MartinNohr/FilamentScale/README.md

# FilamentScale
This is the code for the 3d filament printer weight scale as found in thingiverse and cults3d.
