MartinNohr/FilamentScale/Filament Scale Notes.docx

# Features to Add or Change

# Main Screen

Show spool #

Show remaining weight and length

Show spool weight?

Show rate of consumption?

# Menu Items

## Select Spool

## Change Spool

## Set Weight of full spool

## Calibrate Scale

## Manually set remaining weight
