MartinNohr/FilamentScale/3D/rotator.3mf

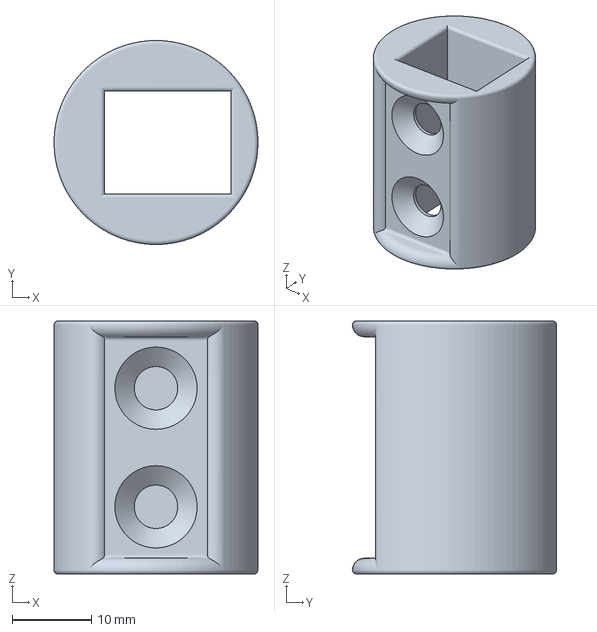
[picture p2: CAD file, 2023-07-01]
3D/rotator.3mf
25.8 x 25.8 x 32.0 mm
