MartinNohr/FilamentScale/3D/mount block.3mf

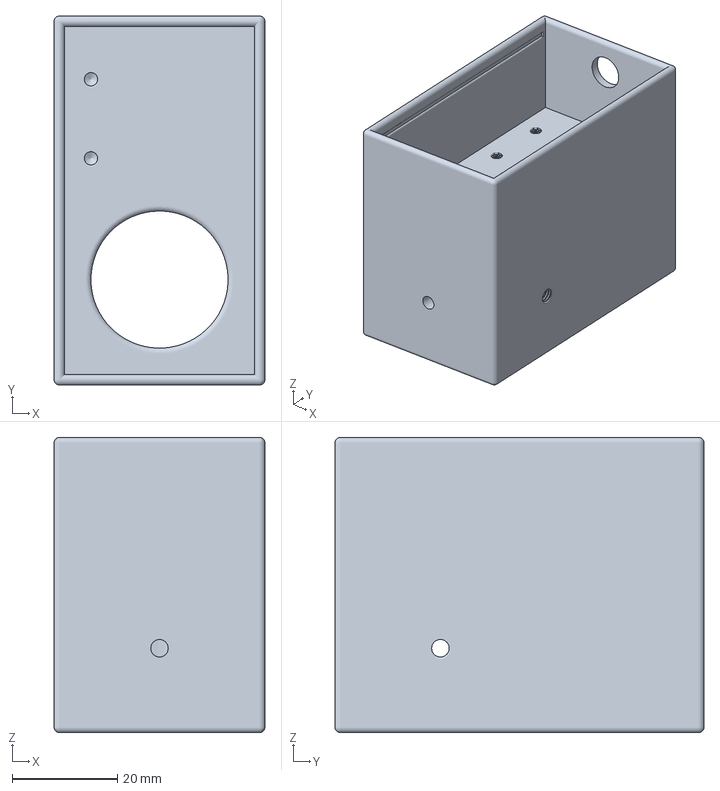
[picture p3: CAD file, 2023-07-01]
3D/mount block.3mf
40.0 x 70.0 x 56.0 mm
