MartinNohr/FilamentScale/3D/inner shaft.3mf

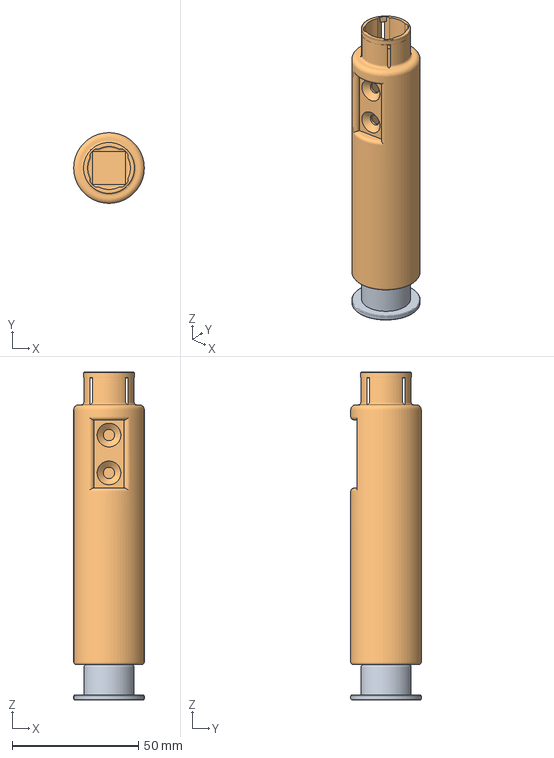
[picture p4: CAD file, 2023-07-01]
3D/inner shaft.3mf
28.0 x 28.0 x 130.0 mm
bearing holder
main shaft
