MartinNohr/FilamentScale/3D/Circuit Cover.3mf

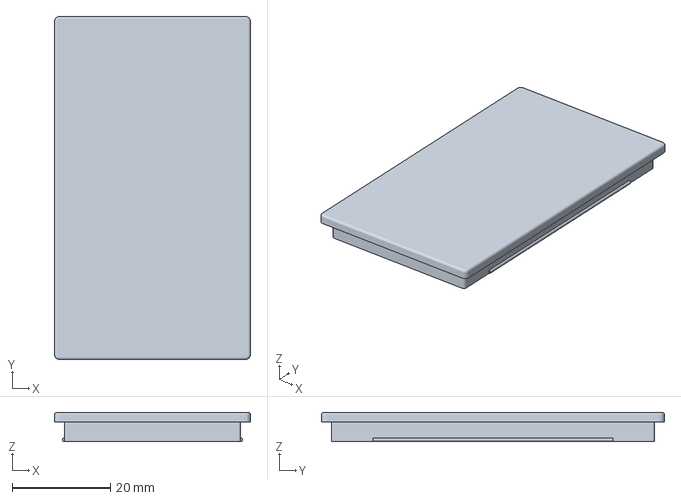
[picture p5: CAD file, 2023-07-01]
3D/Circuit Cover.3mf
40.0 x 70.0 x 6.00 mm
