MartinNohr/FilamentScale/3D/spool shaft.3mf

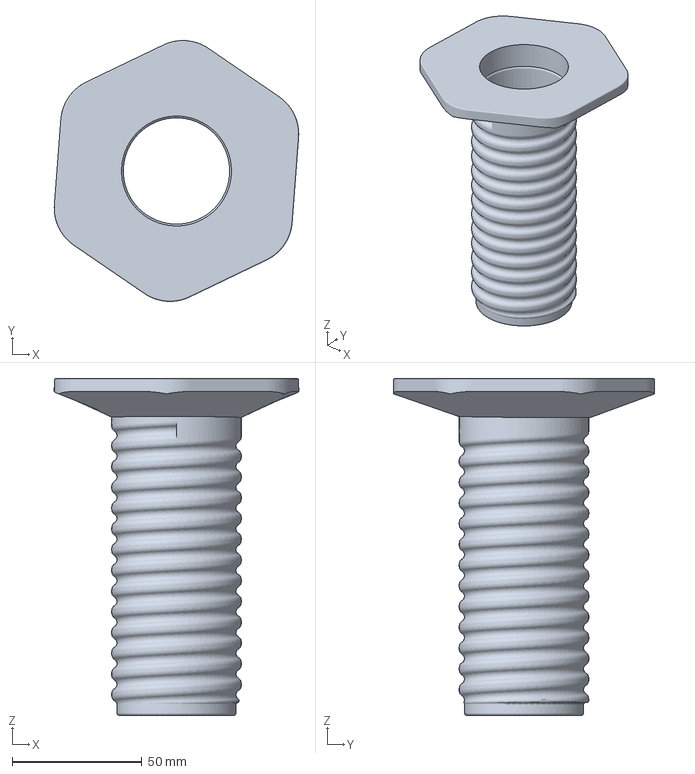
[picture p6: CAD file, 2023-07-01]
3D/spool shaft.3mf
94.3 x 100.6 x 130.0 mm
