MartinNohr/FilamentScale/3D/nut.3mf

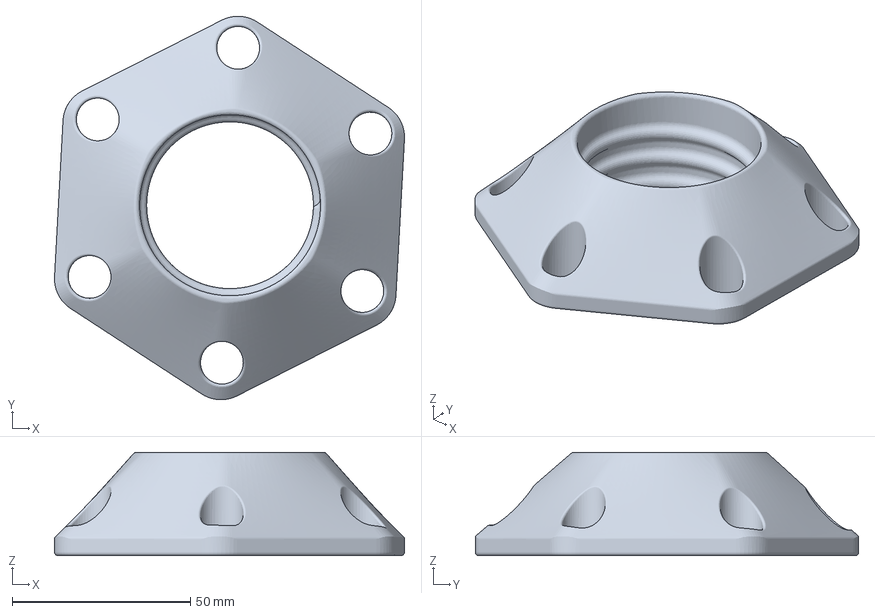
[picture p7: CAD file, 2023-07-01]
3D/nut.3mf
98.2 x 107.6 x 29.0 mm
