MartinNohr/FilamentScale/(list of files, cad)

Other CAD files:
3D/Spool Scale Bracket Rotatable v26.f3d
