MartinNohr/FilamentScale/(threads)

Thread 1 (2021-02-04):

Ground wire needed on loadcell

MartinNohr, 2021-02-04:
I've noticed that the load cell is very sensitive to electrical noise or even being touched with static electricity. It might be helpful to add a ground wire connected to the loadcell.
