MartinNohr/FilamentScale/Schematic_Filament Weigh Scale_2023-06-30.pdf

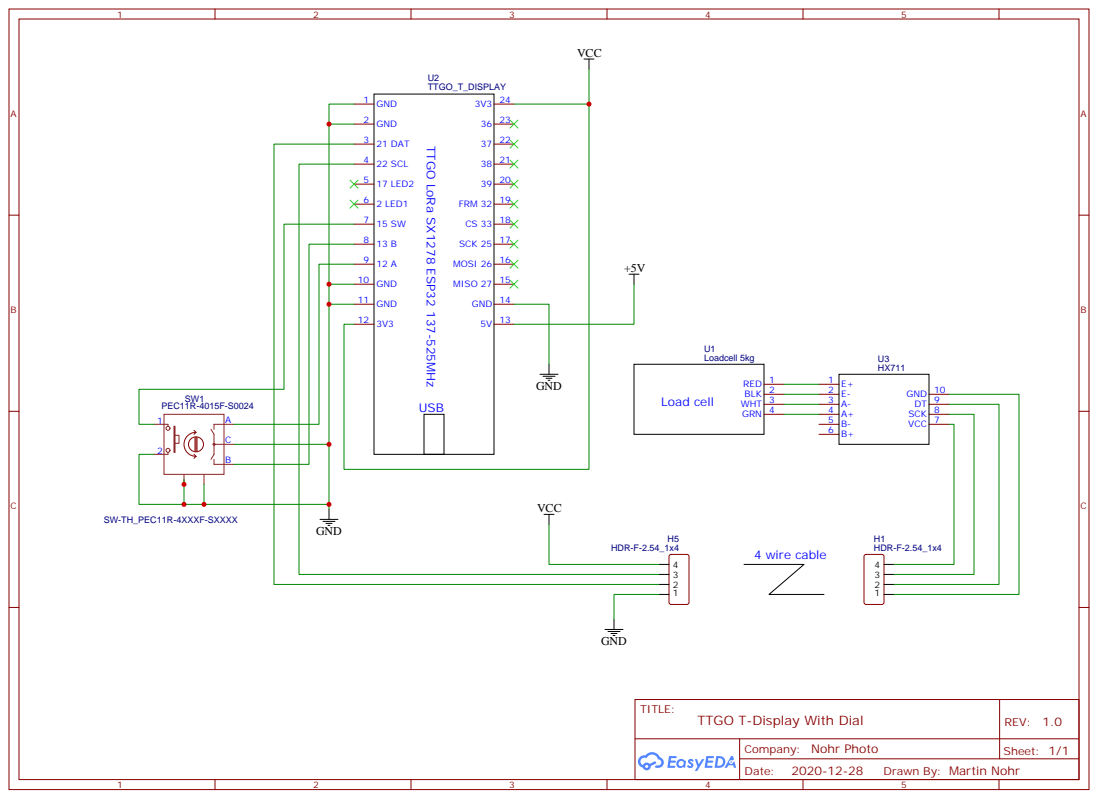
[picture p8: page 1]

Drawn By: Martin Nohr
