MartinNohr/FilamentScale/(commit log)

2021-01-09 Create README.md
    Weighs the amount of filament left on the spool.
    It keeps a list of spools by number so when a spool is switched it can be changed to that spool number to keep track of how much filament is left.
2021-01-22 Improvements to measuring calibration.
2021-01-24 Many fixes, many more to come.
    [FilamentScale.ino]
2021-01-24 Added calibration code.
2021-01-25 Working on calibrate.
2021-01-28 Work on calibration to use dial.
2021-01-28 Calibration almost working.
2021-01-28 Calibration changes.
2021-01-29 Improved calibration code.
2021-01-30 Fixed nActiveSpool to be 1-based.
    [FilamentScale.h, FilamentScale.ino]
2021-01-30 Some menu fixes, long press for access to menu.
    [FilamentScale.h, FilamentScale.ino]
2021-01-30 Fixed spool weight setting.
    [FilamentScale.h, FilamentScale.ino]
2021-01-30 Added tare command and save tare offset. This should allow us to remember settings between power.
2021-01-31 Calibration working again, it was broken.
    [FilamentScale.h, FilamentScale.ino]
2021-01-31 Added spool chooser to spool settings menu. Removed some redundant printlines.
2021-02-01 Some tare and cal save issues fixed.
    [FilamentScale.ino]
2021-02-02 Removed old Serial.println calls and unused eCurrentFile menu code.
2021-02-02 Fixed decimal display while entering integers.
    [FilamentScale.h, FilamentScale.ino]
2021-02-02 Fixed min/max display for decimals in getinteger code.
    [FilamentScale.h, FilamentScale.ino]
2021-02-03 Fixed using filament full length for % full conversion.
    [FilamentScale.ino]
2021-02-03 Added filament usage rate.
2021-02-04 Added schematic to doc.
2021-02-08 Changed calibration text.
2021-02-10 Adjustments for the dial on the PCB.
2021-02-16 Fixed a hang situation if no loadcell. This resulted in killing the bootloader.
    [FilamentScale.ino]
2021-02-24 Fixed calval warning range.
    [FilamentScale.ino]
2021-02-24 Calibration values can be <0! Allow them.
2021-03-09 Change full spool menu to full filament to better reflect what it means.
2021-03-17 Added system menu with brightness, reboot, etc. Put in startup changes for 0 calval so the calibrate code still works.
    [FilamentScale.h, FilamentScale.ino]
2021-03-17 Fixed hang if no load cell.
    [FilamentScale.ino]
2021-04-16 Hold error messages for 2 seconds.
    [FilamentScale.ino]
2022-01-26 Put new esp32encode code in to improve the dial response.
2023-07-01 Added schematic pdf.
2023-07-01 Added Fusion360 source file.
    [Spool Scale Bracket Rotatable v26.f3d]
2023-07-01 Added 3D print files for all the parts.
    [Circuit Cover.3mf, inner shaft.3mf, mount block.3mf, nut.3mf, rotator.3mf, spool shaft.3mf]
2023-07-02 Removed FRAMEBUTTON define, it isn't used.
2024-07-03 Fixed compiling with newer libraries.
    [FilamentScale.h, FilamentScale.ino]
2024-07-08 Improved code, crash on menu return fixed.
    [FilamentScale.h, FilamentScale.ino]
